lambdamikel/mpf-graf-x/images/4297771760628074652.jpg

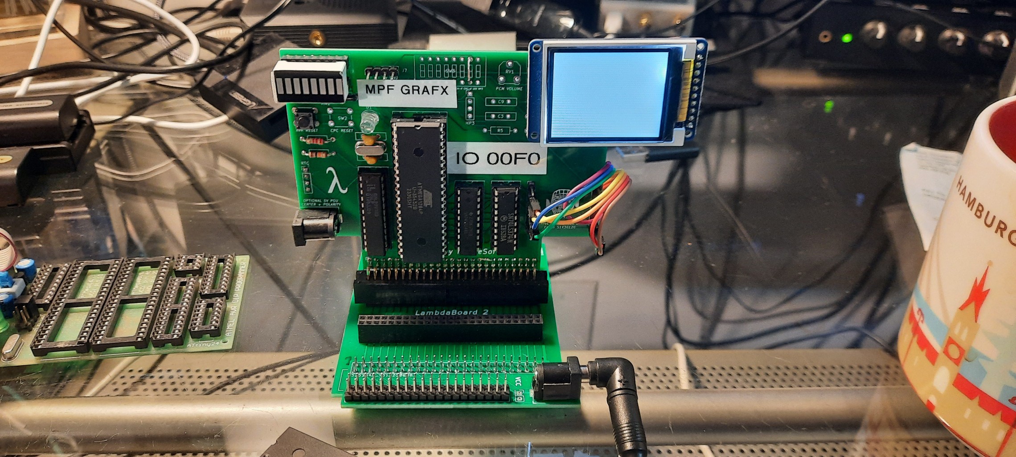
images/4297771760628074652.jpg
