lambdamikel/mpf-graf-x/images/5639691760628359802.jpg

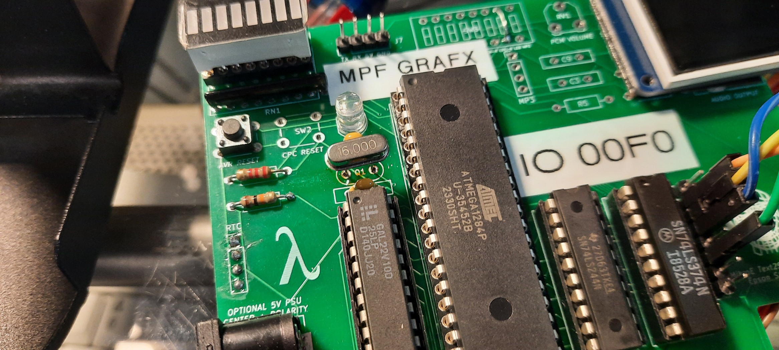
images/5639691760628359802.jpg
