lambdamikel/mpf-graf-x/images/724321760710845330.jpg

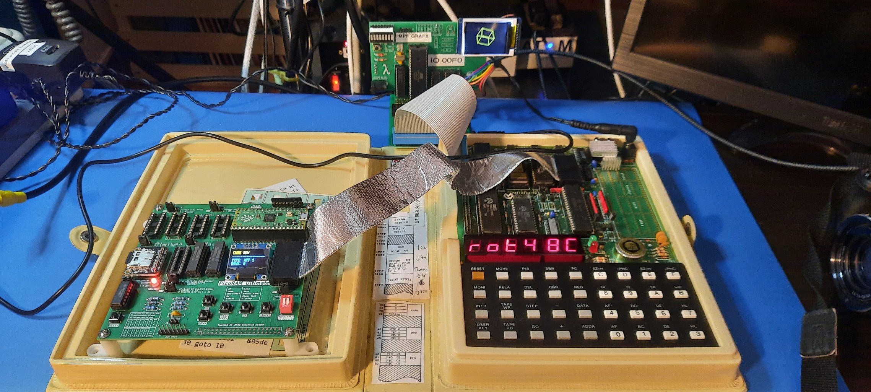
images/724321760710845330.jpg
