lambdamikel/mpf-graf-x/(commit log)

2026-03-08 Initial release of MPF GRAF-X Card firmware, Z80 demos, GAL design, gerbers, and README
2026-03-09 Update README: add LambdaSpeak FS links, TFT wiring section, fix SW3 description
    - Link all LambdaSpeak FS mentions to https://github.com/lambdamikel/LambdaSpeak-FS
    - Add "Connecting the TFT Display" subsection with J2/J3/J7 wiring table and images
    - Fix SW3 description: GND connection for Segment LED Bar (not clock select)
    - Clarify LambdaBoard II BOM entry with adapter/gerbers reference
    - Add new images: display-wires-and-5v-lite.jpg, lite-5v-wire.jpg, j2-j3-headers.png
2026-03-10 Fix 7-segment display labels in README: PEtS→StEP, roloC→Color
